JosueVazqJim/Invernadero-Control-en-lazo-cerrado/README.md

# Invernadero-Control-en-lazo-cerrado
Repositorio de la logica arduino y de python para el monitoreo de temperatura de un invernadero a escala mediante lazo abierto y lazo cerrado
